neilenns/CJ4-Electrical-Panel/Sim reference.png

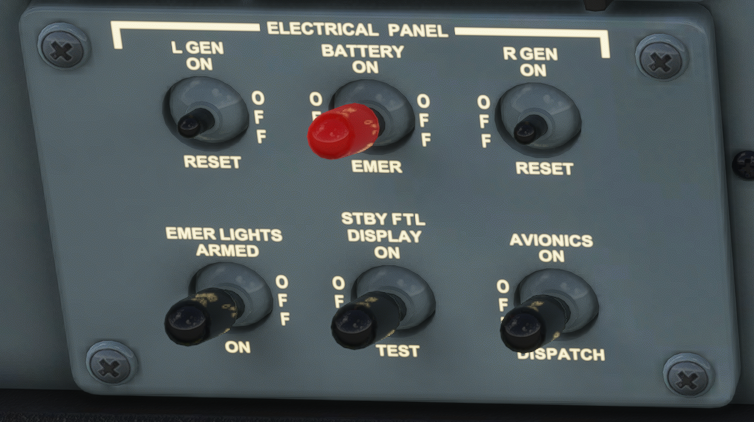
Sim reference.png
