neilenns/CJ4-Electrical-Panel/README.md

# CJ4 electrical panel for use with MobiFlight
