neilenns/CJ4-Electrical-Panel/3D models/UE25BE5510H--3DModel-STEP-533217.STEP

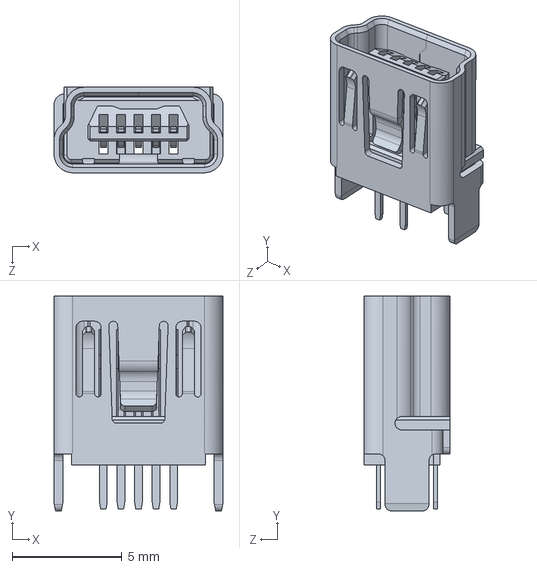
[picture p2: CAD file, 2022-10-09]
3D models/UE25BE5510H--3DModel-STEP-533217.STEP
7.70 x 9.80 x 3.90 mm
