neilenns/CJ4-Electrical-Panel/3D models/ZX80-B-5P.stp

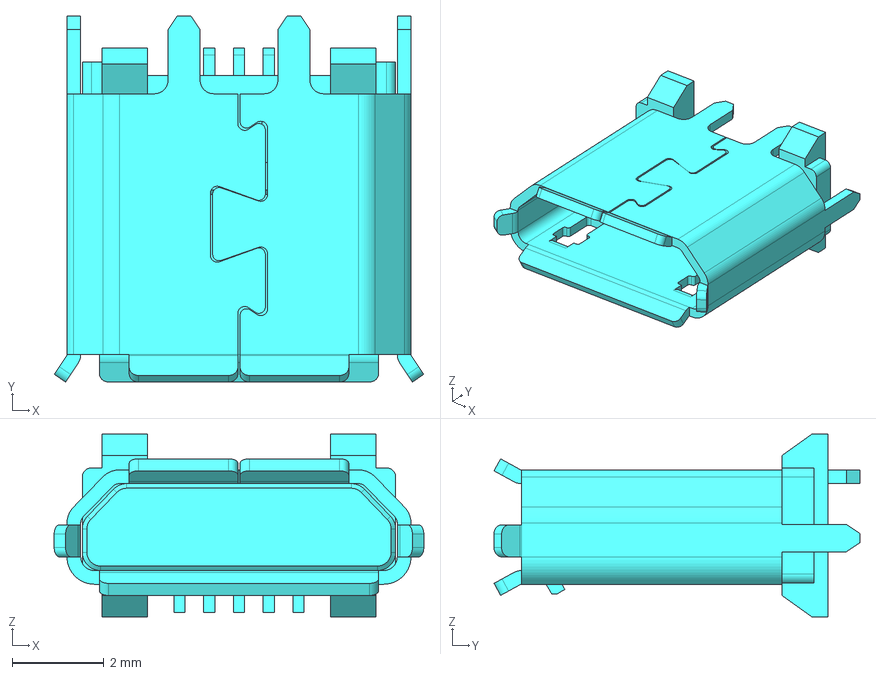
[picture p3: CAD file, 2022-02-07]
3D models/ZX80-B-5P.stp
8.08 x 8.00 x 4.00 mm
