neilenns/CJ4-Electrical-Panel/3D models/Mini toggle SPDT.step

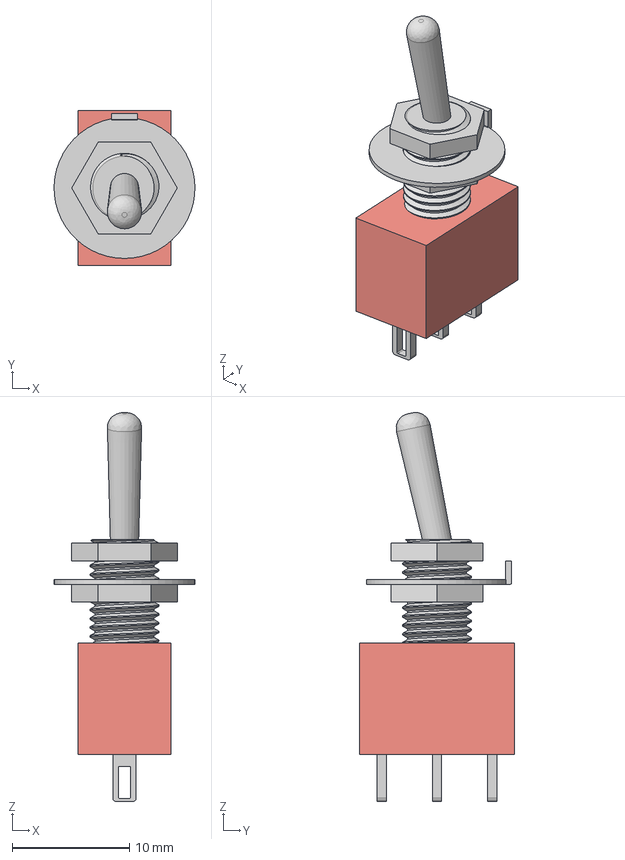
[picture p4: CAD file, 2022-02-06]
3D models/Mini toggle SPDT.step
12.0 x 13.2 x 33.1 mm
Switch body
Mounting screw
Nut x 2
Toggle
