neilenns/CJ4-Electrical-Panel/CJ4-Electrical-Panel.kicad_pcb

## KiCad design CJ4-Electrical-Panel.kicad_pcb (2022-10-09)

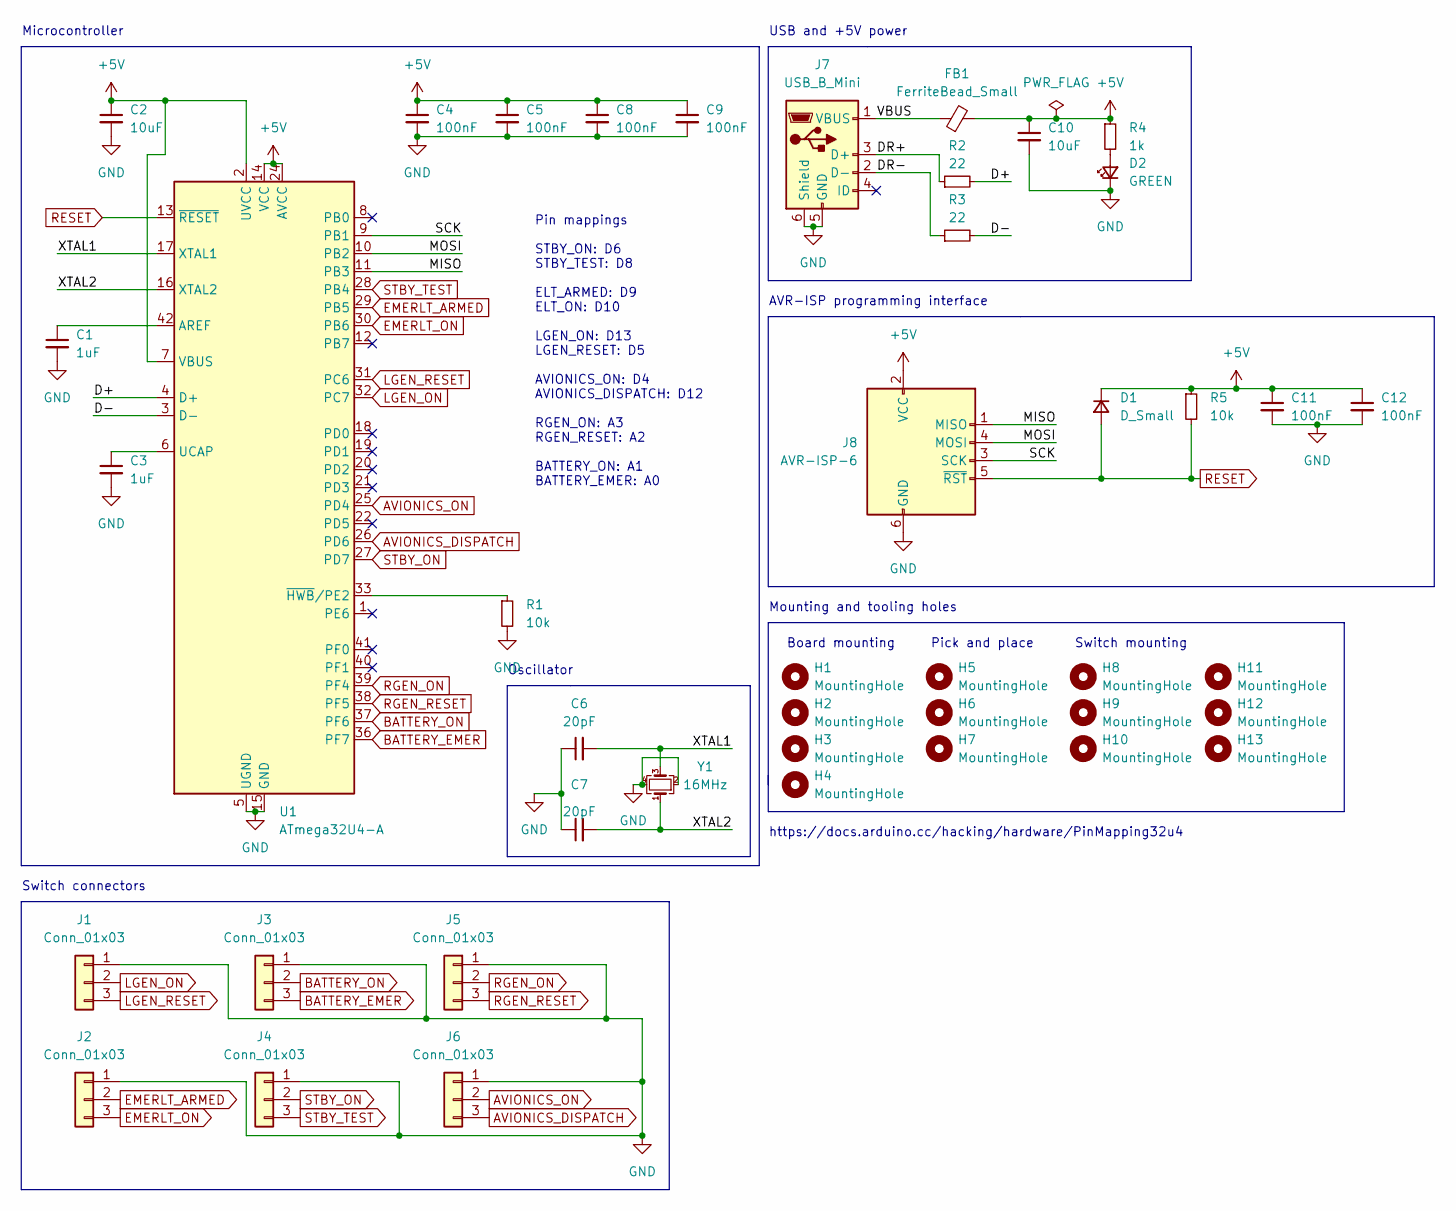
[picture p5: schematic CJ4-Electrical-Panel.kicad_sch, CJ4 electrical panel]

Parts:
C1, C3: 1uF; Perfect_0402; JLC 0402
C2, C10: 10uF; Perfect_0402; JLC 0402
C4, C5, C8, C9, C11, C12: 100nF; Perfect_0402; JLC 0402
C6, C7: 20pF; Perfect_0402; JLC 0402
D1: D_Small; D_SOD-323F; JLC SOD-323F
D2: GREEN; LED_0805_2012Metric_Pad1.15x1.40mm_HandSolder; JLC DNP
FB1: FerriteBead_Small; C_0805_2012Metric; JLC 0805
H1, H2, H3, H4: MountingHole; MountingHole_3.2mm_M3; JLC DNP
H5, H6, H7: MountingHole; JLCPCB_Tooling_Hole; JLC DNP
H8, H9, H10, H11, H12, H13: MountingHole; MiniToggleSPDT_screw_mount; JLC DNP
J1, J2, J3, J4, J5, J6: Conn_01x03; JST_XH_B3B-XH-A_1x03_P2.50mm_Vertical; JLC DNP
J7: USB_B_Mini; USB_B_Mini_Amphenol_UE25BE5510H
J8: AVR-ISP-6; Tag-Connect_TC2030-IDC-NL_2x03_P1.27mm_Vertical; JLC DNP
R1, R5: 10k; Perfect_0402; JLC 0402
R2, R3: 22; Perfect_0402; JLC 0402
R4: 1k; Perfect_0402; JLC 0402
U1: ATmega32U4-A; TQFP-44_10x10mm_P0.8mm; JLC DNP
Y1: 16MHz; Crystal_SMD_3225-4Pin_3.2x2.5mm; JLC SMD-CRY-3225_4P

Connections:
+5V: C2.1, C4.1, C5.1, C8.1, C9.1, C10.1, C11.1, C12.1, D1.1 (K), FB1.2, J8.2 (VCC), R4.1, R5.1, U1.2 (UVCC), U1.7 (VBUS), U1.14 (VCC), U1.24 (AVCC), U1.34 (VCC), U1.44 (AVCC)
/D+: R2.2, U1.4 (D+)
/D-: R3.2, U1.3 (D-)
/DR+: J7.3 (D+), R2.1
/DR-: J7.2 (D-), R3.1
/MISO: J8.1 (MISO), U1.11 (PB3)
/MOSI: J8.4 (MOSI), U1.10 (PB2)
/SCK: J8.3 (SCK), U1.9 (PB1)
/VBUS: FB1.1, J7.1 (VBUS)
/XTAL1: C6.2, U1.17 (XTAL1), Y1.3
/XTAL2: C7.2, U1.16 (XTAL2), Y1.1
AVIONICS_DISPATCH: J6.3, U1.26 (PD6)
AVIONICS_ON: J6.2, U1.25 (PD4)
BATTERY_EMER: J3.3, U1.36 (PF7)
BATTERY_ON: J3.2, U1.37 (PF6)
EMERLT_ARMED: J2.2, U1.29 (PB5)
EMERLT_ON: J2.3, U1.30 (PB6)
GND: C1.2, C2.2, C3.2, C4.2, C5.2, C6.1, C7.1, C8.2, C9.2, C10.2, C11.2, C12.2, D2.1 (K), J1.1, J2.1, J3.1, J4.1, J5.1, J6.1, J7.5 (GND), J7.6 (Shield), J8.6 (GND), R1.2, U1.5 (UGND), U1.15 (GND), U1.23 (GND), U1.35 (GND), U1.43 (GND), Y1.2, Y1.4
LGEN_ON: J1.2, U1.32 (PC7)
LGEN_RESET: J1.3, U1.31 (PC6)
unnamed: C1.1, U1.42 (AREF)
unnamed: C3.1, U1.6 (UCAP)
unnamed: D2.2 (A), R4.2
unnamed: R1.1, U1.33 (~HWB/PE2)
RESET: D1.2 (A), J8.5 (~RST), R5.2, U1.13 (~RESET)
RGEN_ON: J5.2, U1.39 (PF4)
RGEN_RESET: J5.3, U1.38 (PF5)
STBY_ON: J4.2, U1.27 (PD7)
STBY_TEST: J4.3, U1.28 (PB4)

Notes on the sheet:
Pick and place
Pin mappings STBY_ON: D6 STBY_TEST: D8 ELT_ARMED: D9 ELT_ON: D10 LGEN_ON: D13 LGEN_RESET: D5 AVIONICS_ON: D4 AVIONICS_DISPATCH: D12 RGEN_ON: A3 RGEN_RESET: A2 BATTERY_ON: A1 BATTERY_EMER: A0
AVR-ISP programming interface
Switch mounting
Board mounting
Microcontroller
Oscillator
Switch connectors
https://docs.arduino.cc/hacking/hardware/PinMapping32u4
Mounting and tooling holes
USB and +5V power

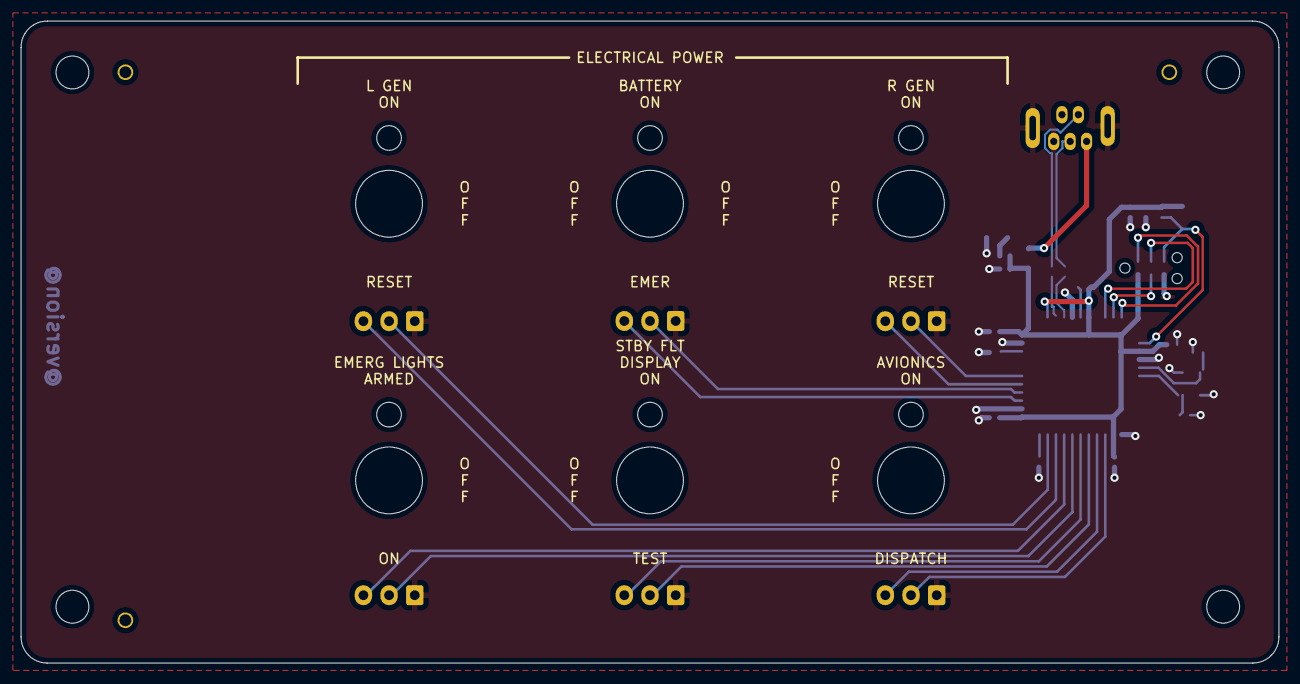
[picture p6: board CJ4-Electrical-Panel.kicad_pcb from above]

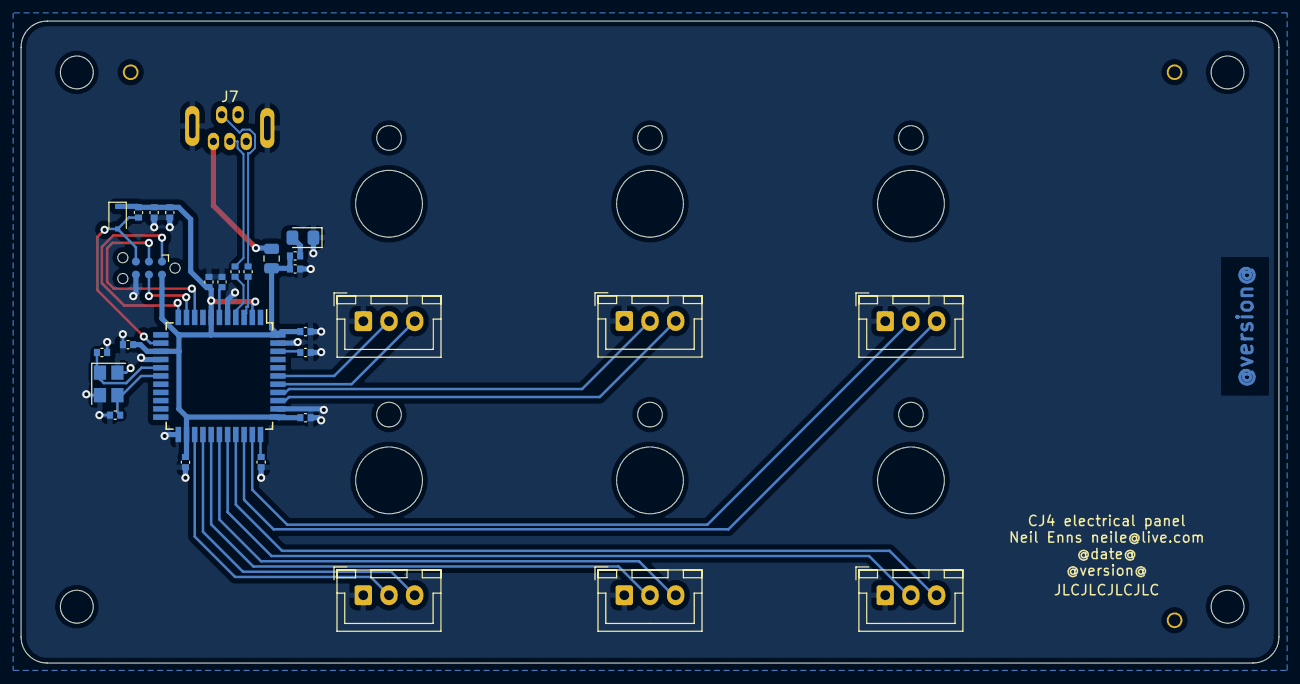
[picture p7: board CJ4-Electrical-Panel.kicad_pcb from below]

Board: 2 copper layers, 122.4 x 62.5 mm, 43 parts (30 on the bottom side), 29 nets.
