neilenns/CJ4-Electrical-Panel/(threads)

Thread 1 (2022-07-01):

Replace USB connector

neilenns, 2022-07-01:
It is HORRIBLE. So easy to rip off the board.

Closed 2022-07-01.

Thread 5 (2022-07-12):

USB footprint is on wrong side of board

neilenns, 2022-07-12:
Was put on the front, should be on the back. Oops. v1.1.0 boards do not work.

Closed 2022-07-12.
