neilenns/CJ4-Electrical-Panel/(commit log)

2022-02-06 Initial work
    [CJ4-Electrical-Panel.kicad_pcb, CJ4-Electrical-Panel.kicad_sch, Mini toggle SPDT.step]
2022-02-06 Finish routing, add JLCPCB part numbers
    [CJ4-Electrical-Panel.kicad_pcb, CJ4-Electrical-Panel.kicad_sch]
2022-02-06 Update to KiCad v6 automation
    [CJ4-Electrical-Panel.kicad_pcb, CJ4-Electrical-Panel.kicad_sch, Mini toggle SPDT.step]
2022-02-06 Add date and version placeholders
    [CJ4-Electrical-Panel.kicad_pcb, CJ4-Electrical-Panel.kicad_sch]
2022-02-06 Add missing starting date
    [CJ4-Electrical-Panel.kicad_pcb, CJ4-Electrical-Panel.kicad_sch]
2022-02-07 All routed and ready for fab
    [CJ4-Electrical-Panel.kicad_pcb, CJ4-Electrical-Panel.kicad_sch]
2022-02-07 Correct footprint error, add USB render
    [CJ4-Electrical-Panel.kicad_sch, ZX80-B-5P.stp]
2022-02-18 Change USB connector, add missing labels
    [CJ4-Electrical-Panel.kicad_pcb, CJ4-Electrical-Panel.kicad_sch]
2022-07-01 Fixes Make switch holes bigger #2
    [CJ4-Electrical-Panel.kicad_pcb, CJ4-Electrical-Panel.kicad_sch]
2022-07-01 Replace USB connector Fixes #1
    [CJ4-Electrical-Panel.kicad_pcb, CJ4-Electrical-Panel.kicad_sch]
2022-07-12 Move USB footprint to back of board
    [CJ4-Electrical-Panel.kicad_pcb]
2022-10-09 Fix 3D models for Fusion 360
    [CJ4-Electrical-Panel.kicad_pcb, UE25BE5510H--3DModel-STEP-533217.STEP]
